rab1515/Jactyl/media/3.jpg

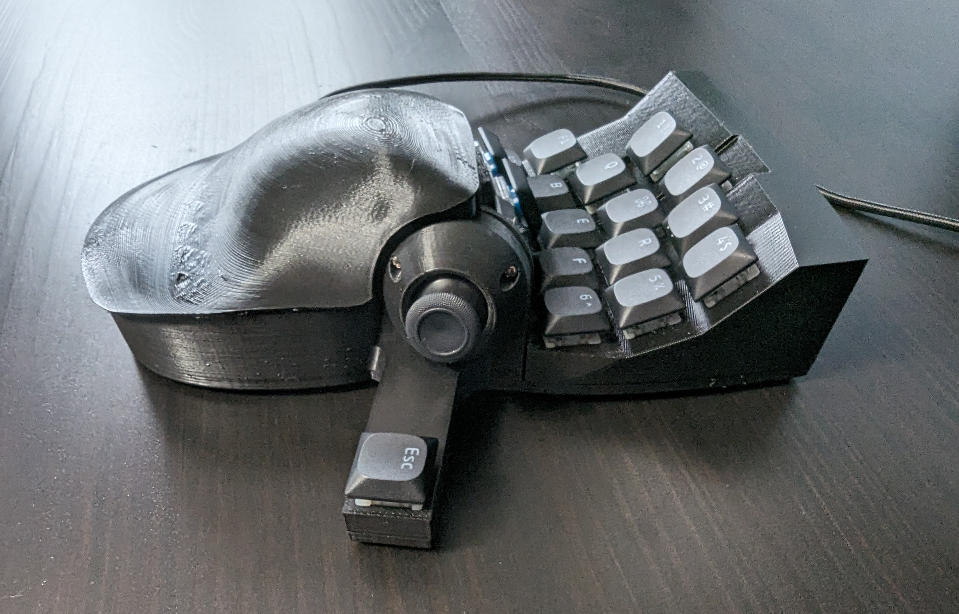
media/3.jpg
