rab1515/Jactyl/media/4.jpg

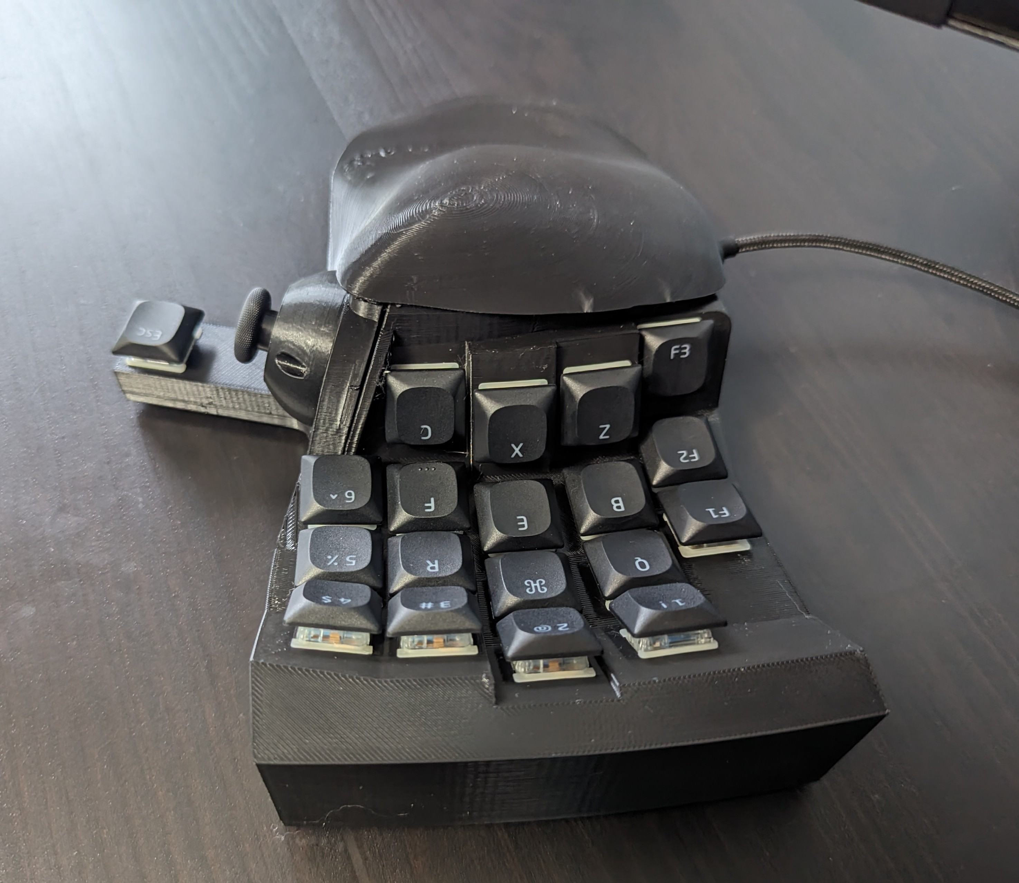
media/4.jpg
