rab1515/Jactyl/media/1.jpg

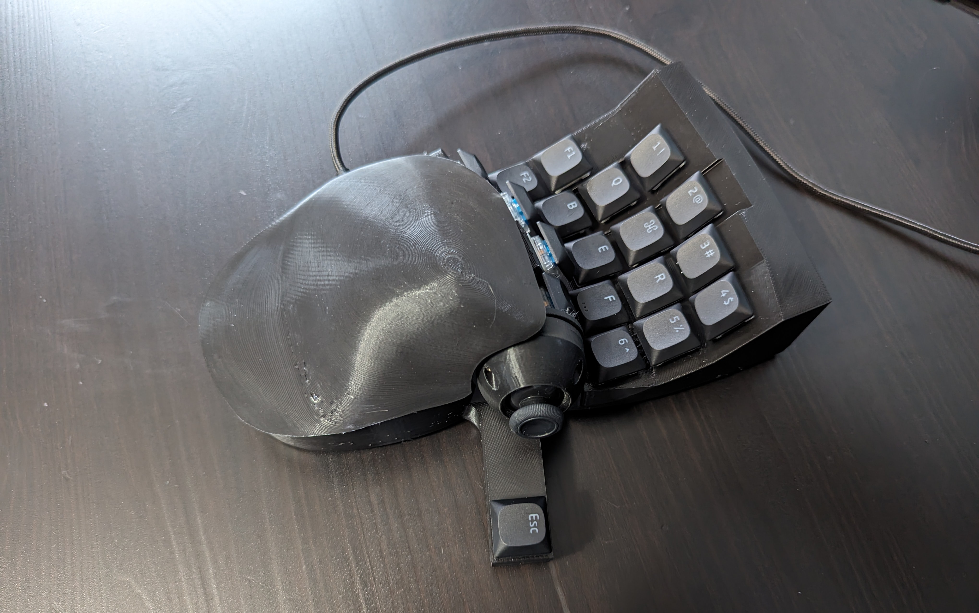
media/1.jpg
