rab1515/Jactyl/stl/jactyl_base.stl

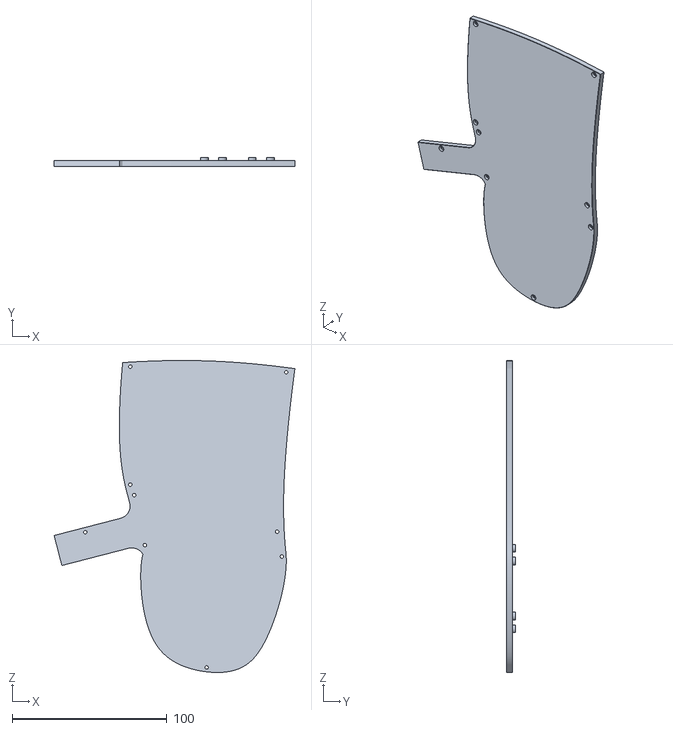
[picture p4: CAD file, 2024-04-12]
stl/jactyl_base.stl
155.4 x 6.00 x 201.3
