rab1515/Jactyl/stl/jactyl_switch_holder.stl

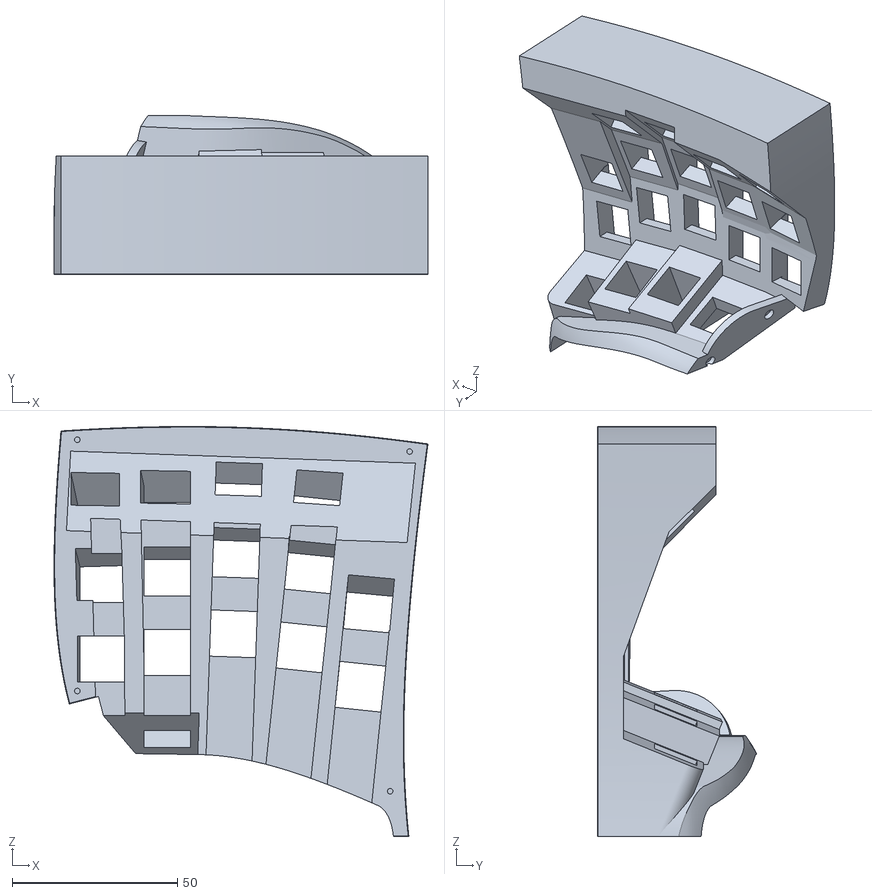
[picture p5: CAD file, 2024-04-12]
stl/jactyl_switch_holder.stl
113.3 x 48.3 x 124.2
