rab1515/Jactyl/kicad/joystick/joystick PCB.kicad_pcb

## KiCad design kicad/joystick/joystick PCB.kicad_pcb (2024-04-12)

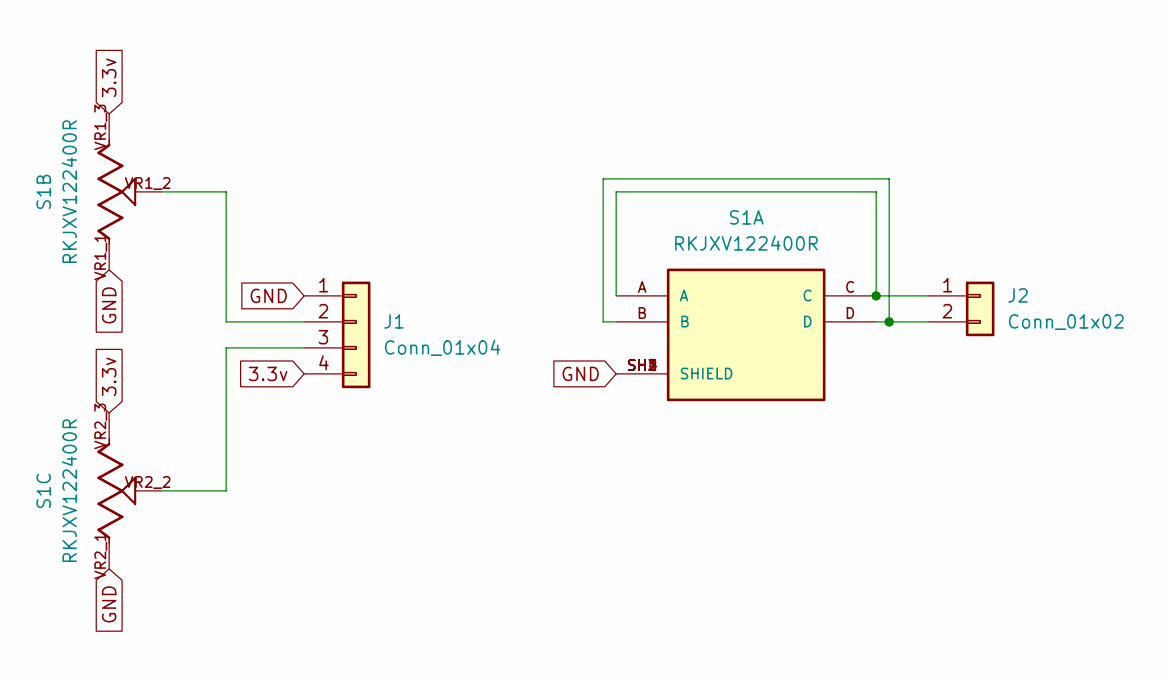
[picture p6: schematic joystick PCB.kicad_sch]

Parts:
J1: Conn_01x04; JST_PH_B4B-PH-K_1x04_P2.00mm_Vertical
J2: Conn_01x02; JST_PH_B2B-PH-K_1x02_P2.00mm_Vertical
S1: RKJXV122400R; SW_RKJXV122400R; PARTREV N/A

Connections:
3.3v: J1.4, S1.VR1_3, S1.VR2_3
GND: J1.1, S1.SH1 (SHIELD), S1.SH2 (SHIELD), S1.SH3 (SHIELD), S1.SH4 (SHIELD), S1.VR1_1, S1.VR2_1
unnamed: J1.2, S1.VR1_2
unnamed: J1.3, S1.VR2_2
unnamed: J2.1, S1.A, S1.C
unnamed: J2.2, S1.B, S1.D

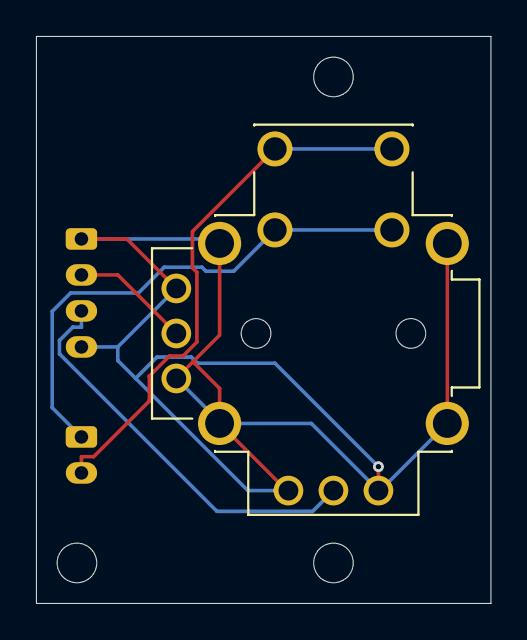
[picture p7: board joystick PCB.kicad_pcb from above]

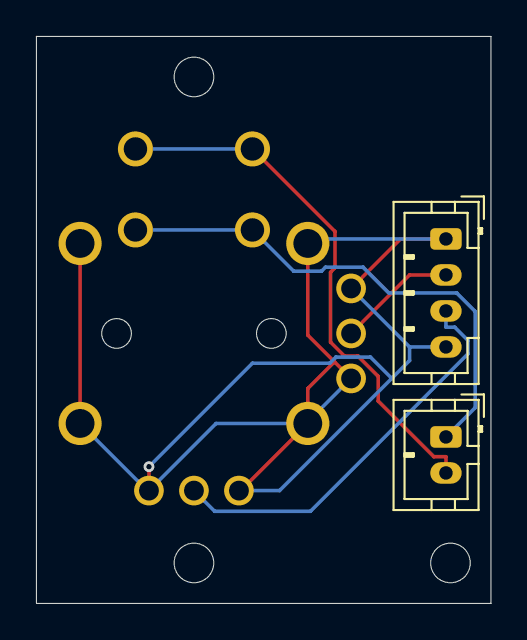
[picture p8: board joystick PCB.kicad_pcb from below]

Board: 2 copper layers, 25.2 x 31.5 mm, 6 parts (2 on the bottom side), 6 nets.

Other parts of the board:
void, void1, void2: MountingHole_2.2mm_M2_DIN965
