rab1515/Jactyl/kicad/mainboard/keyboard matrix v2.kicad_pcb

## KiCad design kicad/mainboard/keyboard matrix v2.kicad_pcb (2024-04-12)

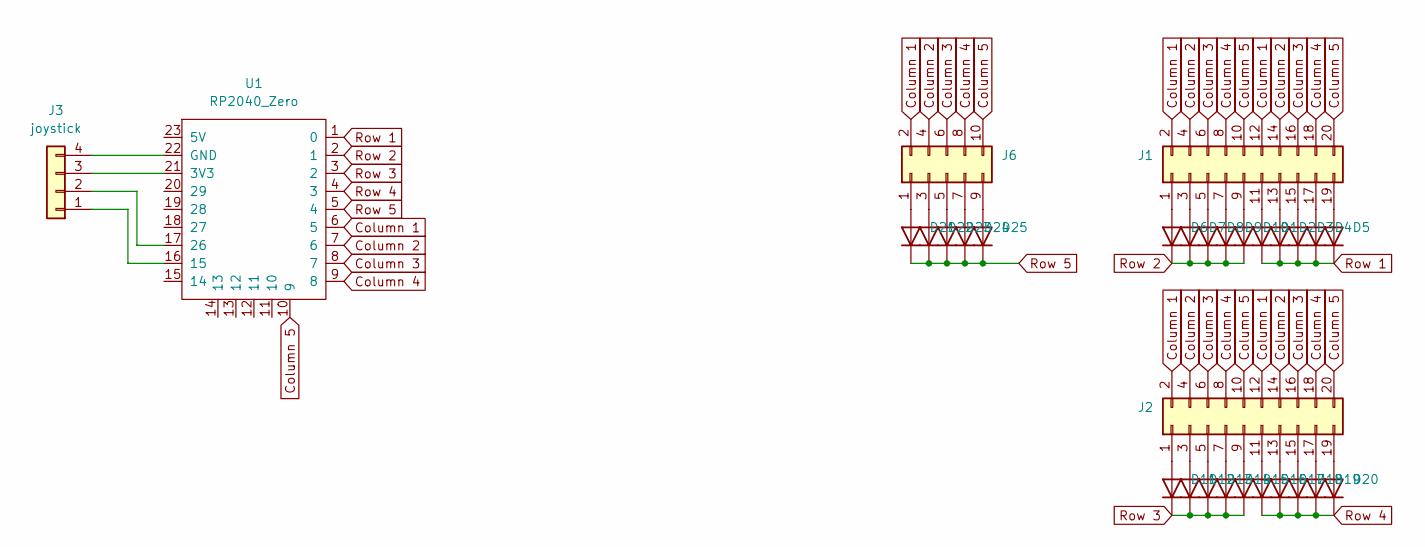
[picture p9: schematic keyboard matrix v2.kicad_sch]

Parts:
D1, D2, D3, D4, D5, D6, D7, D8, D9, D10, D11, D12, D13, D14, D15, D16, D17, D18, D19, D20, D21, D22, D23, D24, D25: Diode; Diode_DO-35
J1, J2: Conn_02x10_Odd_Even; PinHeader_2x10_P2.54mm_Vertical
J3: joystick; JST_PH_B4B-PH-K_1x04_P2.00mm_Vertical
J6: Conn_02x05_Odd_Even; PinHeader_2x05_P2.54mm_Vertical
U1: RP2040_Zero

Connections:
Column 1: J1.2, J1.12, J2.2, J2.12, J6.2, U1.6 (5)
Column 2: J1.4, J1.14, J2.4, J2.14, J6.4, U1.7 (6)
Column 3: J1.6, J1.16, J2.6, J2.16, J6.6, U1.8 (7)
Column 4: J1.8, J1.18, J2.8, J2.18, J6.8, U1.9 (8)
Column 5: J1.10, J1.20, J2.10, J2.20, J6.10, U1.10 (9)
unnamed: D1.2 (A), J1.11
unnamed: D2.2 (A), J1.13
unnamed: D3.2 (A), J1.15
unnamed: D4.2 (A), J1.17
unnamed: D5.2 (A), J1.19
unnamed: D6.2 (A), J1.1
unnamed: D7.2 (A), J1.3
unnamed: D8.2 (A), J1.5
unnamed: D9.2 (A), J1.7
unnamed: D10.2 (A), J1.9
unnamed: D11.2 (A), J2.1
unnamed: D12.2 (A), J2.3
unnamed: D13.2 (A), J2.5
unnamed: D14.2 (A), J2.7
unnamed: D15.2 (A), J2.9
unnamed: D16.2 (A), J2.11
unnamed: D17.2 (A), J2.13
unnamed: D18.2 (A), J2.15
unnamed: D19.2 (A), J2.17
unnamed: D20.2 (A), J2.19
unnamed: D21.2 (A), J6.1
unnamed: D22.2 (A), J6.3
unnamed: D23.2 (A), J6.5
unnamed: D24.2 (A), J6.7
unnamed: D25.2 (A), J6.9
unnamed: J3.1, U1.16 (15)
unnamed: J3.2, U1.17 (26)
unnamed: J3.3, U1.21 (3V3)
unnamed: J3.4, U1.22 (GND)
Row 1: D1.1 (K), D2.1 (K), D3.1 (K), D4.1 (K), D5.1 (K), U1.1 (0)
Row 2: D6.1 (K), D7.1 (K), D8.1 (K), D9.1 (K), D10.1 (K), U1.2 (1)
Row 3: D11.1 (K), D12.1 (K), D13.1 (K), D14.1 (K), D15.1 (K), U1.3 (2)
Row 4: D16.1 (K), D17.1 (K), D18.1 (K), D19.1 (K), D20.1 (K), U1.4 (3)
Row 5: D21.1 (K), D22.1 (K), D23.1 (K), D24.1 (K), D25.1 (K), U1.5 (4)

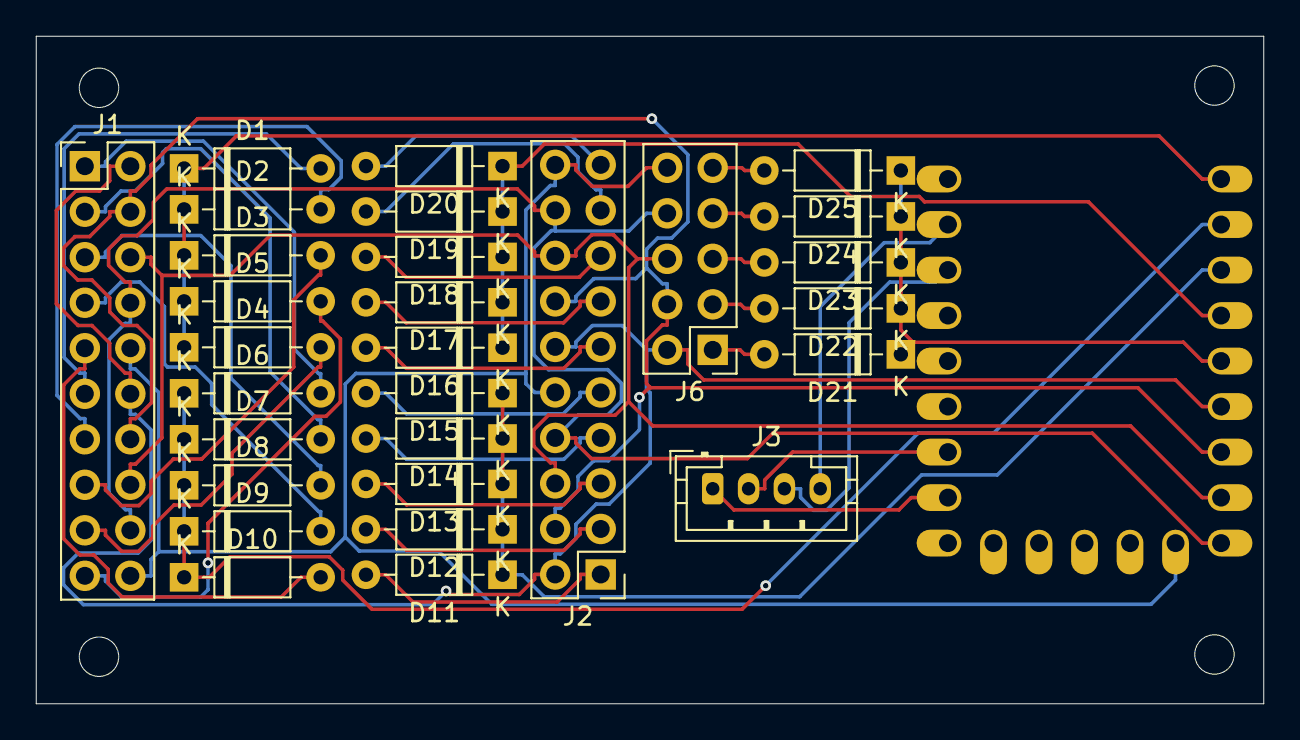
[picture p10: board keyboard matrix v2.kicad_pcb from above]

Board: 2 copper layers, 68.5 x 37.2 mm, 34 parts (0 on the bottom side), 39 nets.

Other parts of the board:
foo, foo1, foo2, foo3: MountingHole_2.2mm_M2
