rab1515/Jactyl/(threads)

Thread 4 (2024-04-10):

Joystick PCB does not fit

rab1515, 2024-04-10:
There is no recess for the JST pin headers on the back side of the PCB, so the joystick PCB does not sit flush. Some of the screw holes/lengths might need to be adjusted.
