rab1515/Jactyl/(commit log)

2024-04-12 added kicad projects
    [joystick PCB.kicad_pcb, joystick PCB.kicad_sch, keyboard matrix v2.kicad_pcb, keyboard matrix v2.kicad_sch]
2024-04-12 added photos and STL's
    [jactyl_base.stl, jactyl_switch_holder.stl]
